ABlairJamieson/Temperature_Sensor_I2C/includes/TMP117AIDRVR/TMP117AIDRVR.step

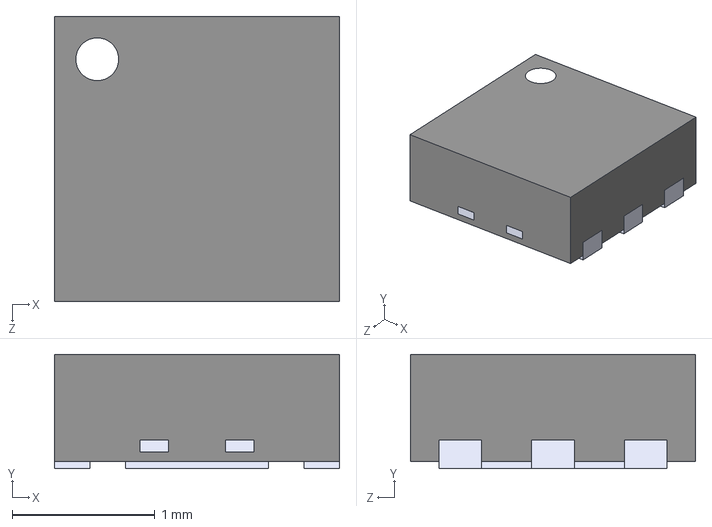
[picture p1: CAD file, 2026-10-26]
includes/TMP117AIDRVR/TMP117AIDRVR.step
2.00 x 0.8 x 2.00 mm
