ABlairJamieson/Temperature_Sensor_I2C/Temperature Sensor I2C.kicad_pcb

## KiCad design Temperature Sensor I2C.kicad_pcb (2026-10-26)

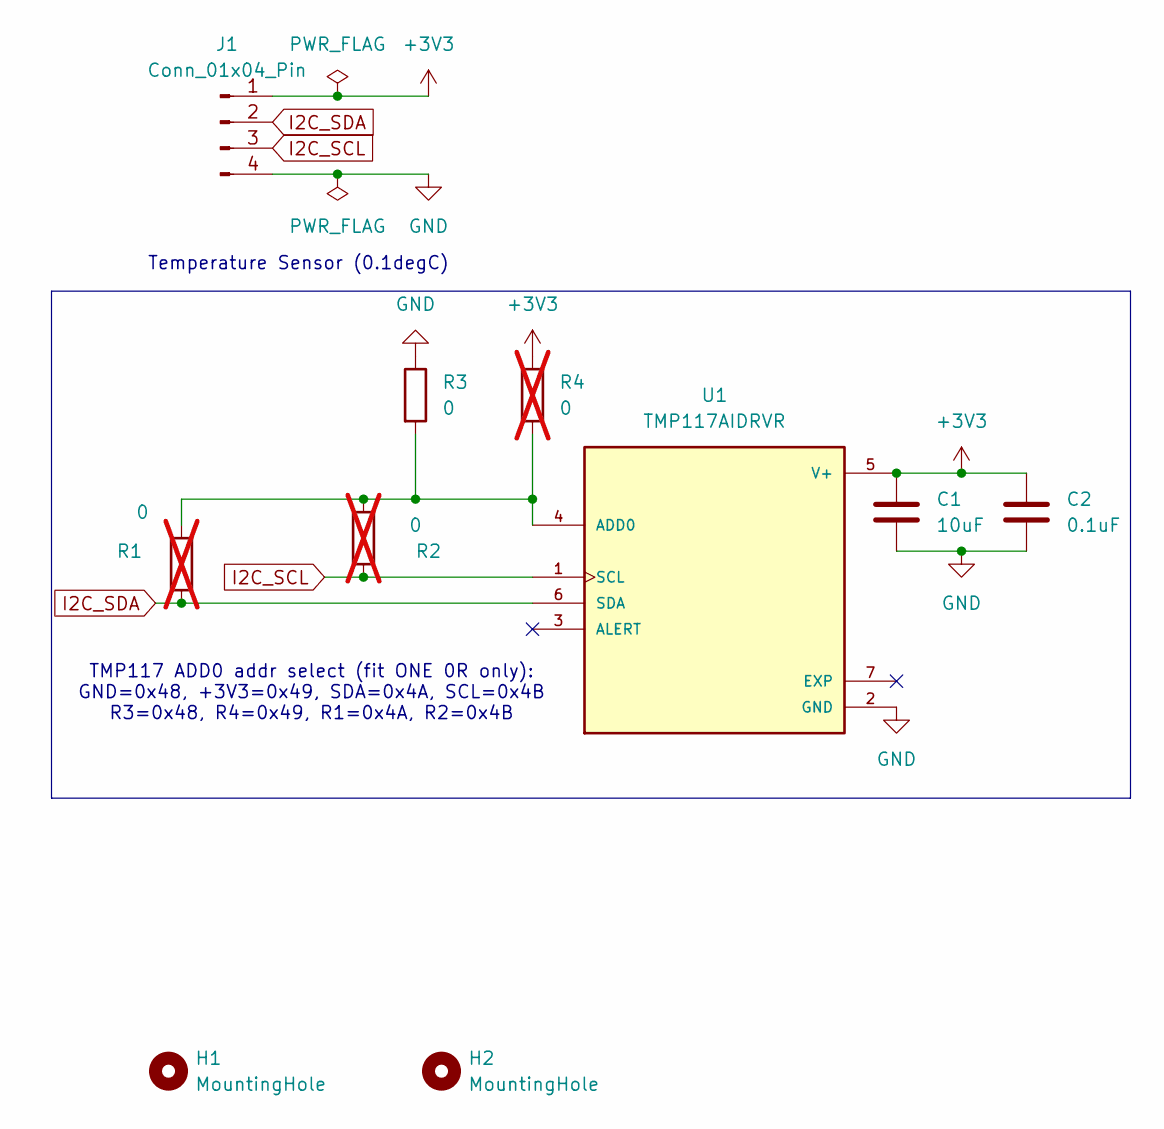
[picture p2: schematic Temperature Sensor I2C.kicad_sch]

Parts:
C1: 10uF; C_0805_2012Metric
C2: 0.1uF; C_0402_1005Metric
H1, H2: MountingHole; MountingHole_3.2mm_M3
J1: Conn_01x04_Pin; JST_PH_B4B-PH-K_1x04_P2.00mm_Vertical
R1, R2, R4: 0; R_0603_1608Metric; not fitted
R3: 0; R_0603_1608Metric
U1: TMP117AIDRVR; SON65P200X200X80-7N; PARTREV B; DigiKey_Part_Number 296-51834-1-ND

Connections:
+3V3: C1.1, C2.1, J1.1, R4.1, U1.5 (V+)
GND: C1.2, C2.2, J1.4, R3.1, U1.2 (GND)
I2C_SCL: J1.3, R2.1, U1.1 (SCL)
I2C_SDA: J1.2, R1.1, U1.6 (SDA)
unnamed: R1.2, R2.2, R3.2, R4.2, U1.4 (ADD0)

Notes on the sheet:
Temperature Sensor (0.1degC)
TMP117 ADD0 addr select (fit ONE 0R only): GND=0x48, +3V3=0x49, SDA=0x4A, SCL=0x4B R3=0x48, R4=0x49, R1=0x4A, R2=0x4B

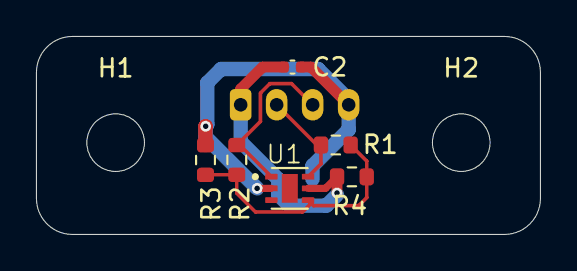
[picture p3: board Temperature Sensor I2C.kicad_pcb from above]

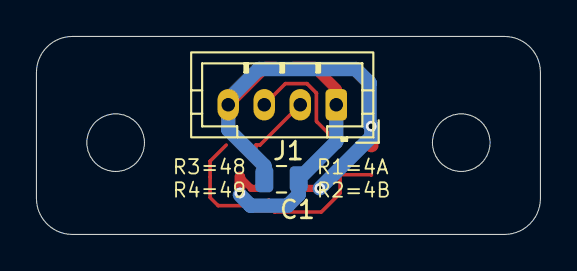
[picture p4: board Temperature Sensor I2C.kicad_pcb from below]

Board: 2 copper layers, 28.0 x 11.0 mm, 10 parts (2 on the bottom side), 5 nets.
