ABlairJamieson/Temperature_Sensor_I2C/(commit log)

2026-10-26 Save TMP117 I2C temperature sensor board and local libraries
    [TMP117AIDRVR.step, Temperature Sensor I2C.kicad_pcb, Temperature Sensor I2C.kicad_sch]
2026-10-26 Document sensor wiring, address selection and bring-up
